bpuklich/d710-gps/images/IMG_20131108_212835.jpg

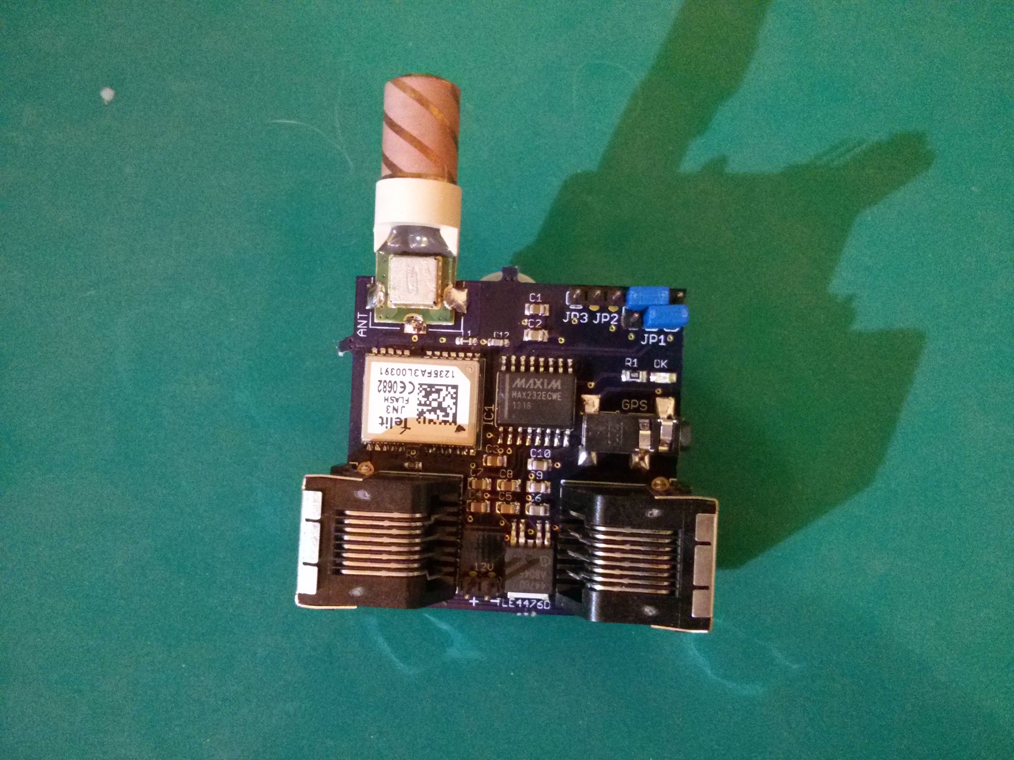
images/IMG_20131108_212835.jpg
