bpuklich/d710-gps/images/top.png

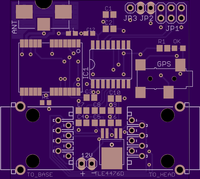
images/top.png
