bpuklich/d710-gps/images/bottom.png

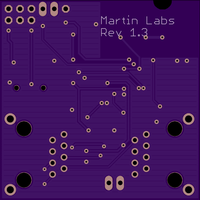
images/bottom.png
