bpuklich/d710-gps/Digikey D710 GPS Parts Pricing.xlsx

Part # | Part | How many / board | $ Per 1 | $ Per 10 | $ Per 100 | $ Per 1000
 |  |  | 1 | 10 | 100 | 1000
943-1016-1-ND | JN3 GPS Module | 1 | 19.17 | 16.43 | 14.375 | 14.375
TLE4476DCT-ND | IC REG TLE4476D | 1 | 3.32 | 2.985 | 2.4325 | 1.65855
1276-2910-1-ND | Cap Ceramic 22uF 10V | 2 | 0.4 | 0.346 | 0.173 | 0.11371
1276-1074-1-ND | Cap Ceramic .47uF 25V | 1 | 0.12 | 0.084 | 0.0385 | 0.021
1276-1007-1-ND | Cap Ceramic .1uF 50V | 1 | 0.1 | 0.031 | 0.0141 | 0.00768
1276-2893-1-ND | Cap Ceramic 10uF 16V | 1 | 0.2 | 0.137 | 0.0696 | 0.04228
1276-2953-1-ND | Cap Ceramic 2.2uF 25V | 1 | 0.16 | 0.11 | 0.0523 | 0.03031
P62ADCT-ND | Res 62 Ohm 1/4W | 1 | 0.23 | 0.0874 | 0.0665 | 0.02432
P100KGCT-ND | Res 100 Ohm 1/10W | 2 | 0.1 | 0.0092 | 0.007 | 0.00256
160-1423-1-ND | LED Green 0805 | 1 | 0.32 | 0.248 | 0.135 | 0.0585
CP-2524SJCT-ND | Conn Audio Jack 2.5mm | 1 | 1.28 | 0.998 | 0.7614 | 0.4912
A31437-ND | Conn RJ45 | 2 | 2.02 | 1.832 | 1.5707 | 1.12193
MAX232ECWE+-ND | MAX232ECWE | 1 | 4.88 | 4.636 | 2.36 | 2.07826
311-1457-1-ND | Cap Ceramic 1uF 16V | 4 | 0.1 | 0.044 | 0.0202 | 0.01101
D710GPSv2 | 2-layer PCB Board made | 1 | 6 | 6 | 6 | 6
SL1204R | Quadrifilar geo helix GPS antenna | 1 | 19 | 19 | 19 | 19
490-2631-1-ND | INDUCTOR 47NH 200MA 0402 | 1 | 0.1 | 0.064 | 0.0448 | 0.03328
490-5868-1-ND | CAP CER 22PF 50V 5% NP0 0402 | 1 | 0.1 | 0.021 | 0.0096 | 0.00525
 |  | Cost Per 1 | 62.02
 |  | Cost Per 10 |  | 55.3818
 |  | Cost Per 100 |  |  | 48.9415
 |  | Cost Per 1000 |  |  |  | 46.34607
 |  | Total investment cost | 62.02 | 553.818 | 4894.15 | 46346.07
 |  | Profit if sold @ $50 | -12.02 | -53.818 | 105.85 | 3653.93
 |  | Profit if sold @ $60 | -2.02 | 46.182 | 1105.85 | 13653.93
 |  | Profit if sold @ $70 | 7.98 | 146.182 | 2105.85 | 23653.93
 |  | Profit if sold @ $80 | 17.98 | 246.182 | 3105.85 | 33653.93
 |  | Profit if sold @ $90 | 27.98 | 346.182 | 4105.85 | 43653.93
 |  | Profit if sold @ $100 | 37.98 | 446.182 | 5105.85 | 53653.93
Geo Helix | http://www.richardsonrfpd.com/Pages/Search-Results.aspx?productCategory=10106&supplierid=1054
 | http://www.richardsonrfpd.com/Pages/Product-Details.aspx?productId=922306
http://www.vetco.net/catalog/product_info.php?products_id=7679
