bpuklich/d710-gps/D710-gps.brd

## EAGLE design D710-gps.brd (2014-01-22)

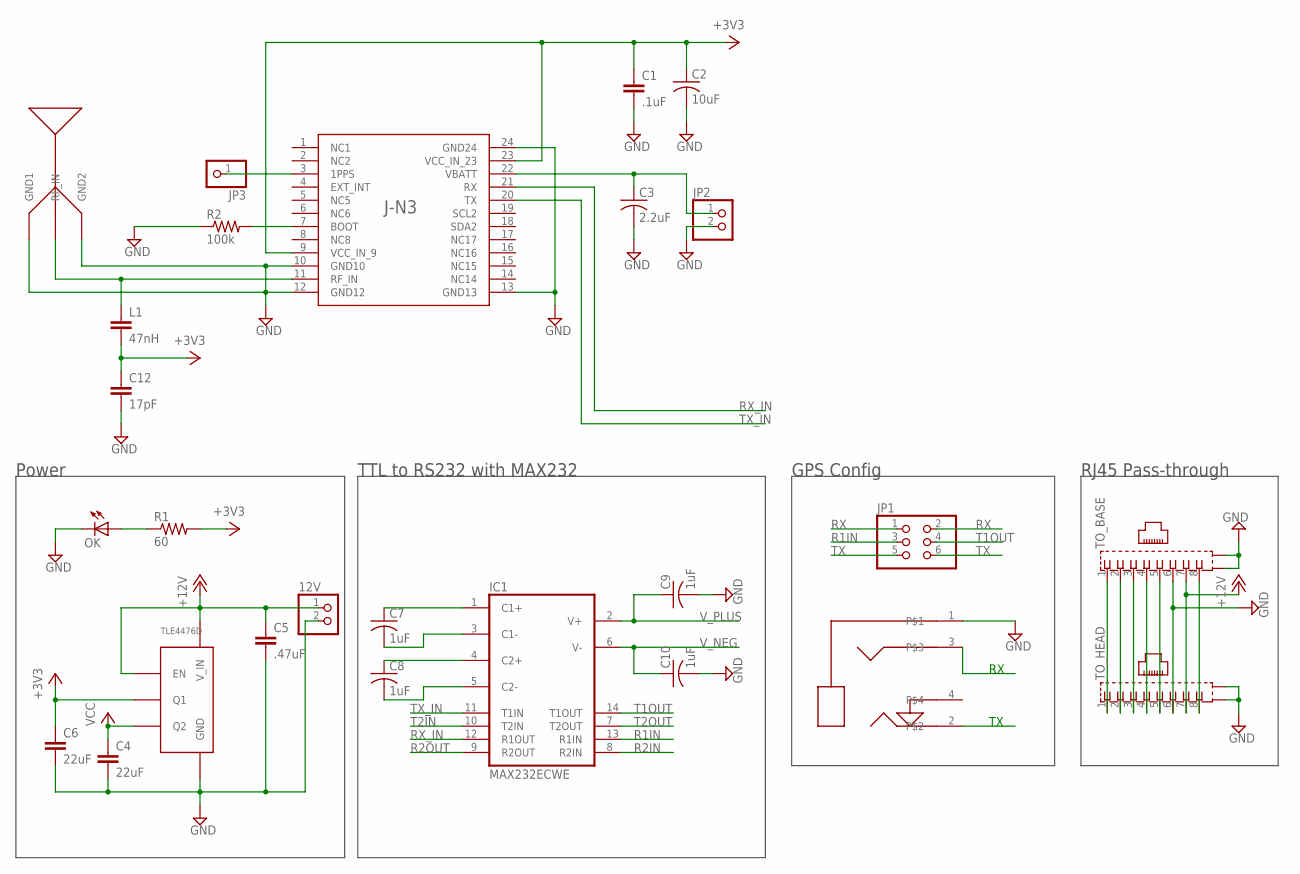
[picture p4: schematic D710-gps.sch]

Parts:
12V: PINHD-1X2; 1X02
ANT: GEO_HELIX_GPSANT
C1: .1uF; C0805
C2: 10uF; C0805; MPN 06034D106MAT2A
C3: 2.2uF; C0805
C4, C6: 22uF; C0805
C5: .47uF; C0805
C7, C8, C9, C10: 1uF; C0805; MPN 02016D105MAT2A
C12: 17pF; C0603
GPS: 2.5MM_JACK; 2.5MM_AUDIO
IC1: MAX232ECWE; SO16L
JP1: PINHD-2X3; 2X03
JP2: PINHD-1X2; 1X02
JP3: PINHD-1X1; 1X01
L1: 47nH; C0603
OK: LEDCHIPLED_0805; CHIPLED_0805
R1: 60; R0805
R2: 100k; R0603
TLE4476D: TLE4476D; TO-252-5
TO_BASE: 555141-1; 555153-1
TO_HEAD: 555141-1; 555153-1
U$1: TELIT_JN3; 24-SMD

Connections:
+3V3: C1.1, C2.1, C6.1, C12.1, L1.2, R1.2, TLE4476D.Q1, U$1.9 (VCC_IN_9), U$1.23 (VCC_IN_23)
+5V: C4.1, IC1.16 (VCC), TLE4476D.Q2
+12V: 12V.1, C5.1, TLE4476D.EN, TLE4476D.V_IN, TO_BASE.7, TO_HEAD.7
GND: 12V.2, ANT.GND1, ANT.GND2, C1.2, C2.2, C3.2, C4.2, C5.2, C6.2, C9.2, C10.2, C12.2, GPS.1, IC1.15 (GND), JP2.2, OK.C, R2.1, TLE4476D.GND, TO_BASE.6, TO_BASE.G1 (S1), TO_BASE.G2 (S2), TO_HEAD.6, TO_HEAD.G1 (S1), TO_HEAD.G2 (S2), U$1.10 (GND10), U$1.12 (GND12), U$1.13 (GND13), U$1.24 (GND24)
unnamed: ANT.RF_IN, L1.1, U$1.11 (RF_IN)
unnamed: OK.A, R1.1
unnamed: R2.2, U$1.7 (BOOT)
unnamed: C3.1, JP2.1, U$1.22 (VBATT)
unnamed: JP3.1, U$1.3 (1PPS)
unnamed: C7.1, IC1.1 (C1+)
unnamed: C7.2, IC1.3 (C1-)
unnamed: C8.1, IC1.4 (C2+)
unnamed: C8.2, IC1.5 (C2-)
unnamed: TO_BASE.1, TO_HEAD.1
unnamed: TO_BASE.2, TO_HEAD.2
unnamed: TO_BASE.3, TO_HEAD.3
unnamed: TO_BASE.4, TO_HEAD.4
unnamed: TO_BASE.5, TO_HEAD.5
unnamed: TO_BASE.8, TO_HEAD.8
R1IN: IC1.13 (R1IN), JP1.3
R2IN: IC1.8 (R2IN)
R2OUT: IC1.9 (R2OUT)
RX: GPS.3, JP1.1, JP1.2
RX_IN: IC1.12 (R1OUT), U$1.21 (RX)
T1OUT: IC1.14 (T1OUT), JP1.4
T2IN: IC1.10 (T2IN)
T2OUT: IC1.7 (T2OUT)
TX: GPS.2, JP1.5, JP1.6
TX_IN: IC1.11 (T1IN), U$1.20 (TX)
V_NEG: C10.1, IC1.6 (V-)
V_PLUS: C9.1, IC1.2 (V+)

Notes on the sheet:
GPS Config
RJ45 Pass-through
Power
TTL to RS232 with MAX232

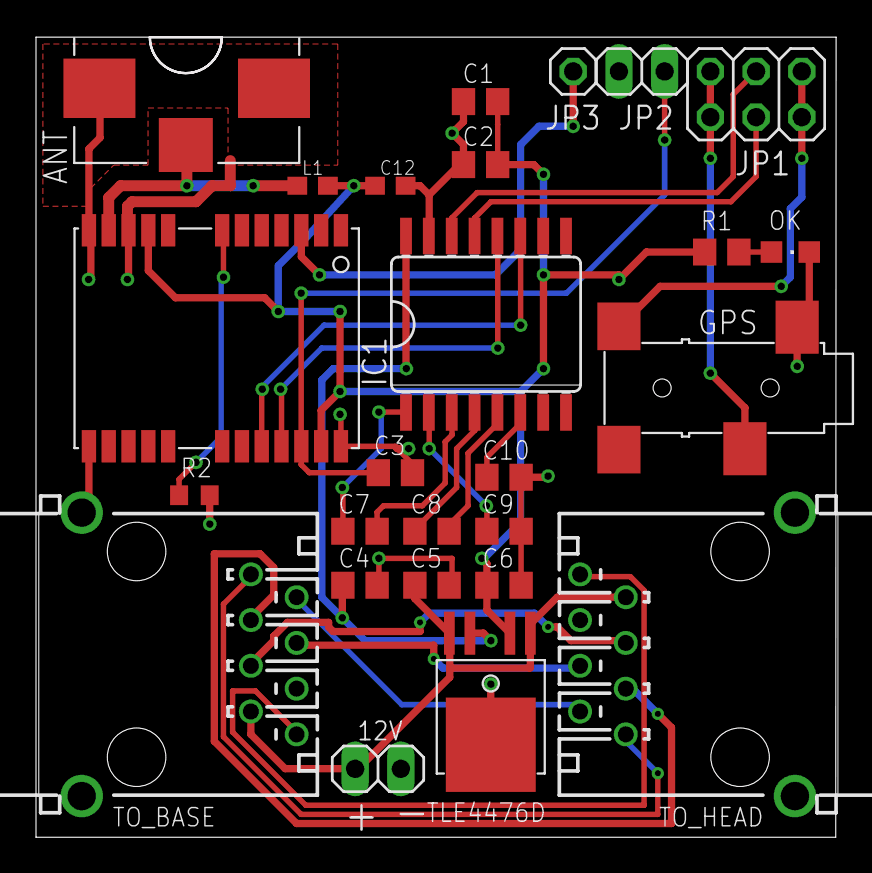
[picture p5: board D710-gps.brd from above]

Board: 2 copper layers, 44.5 x 44.5 mm, 26 parts (0 on the bottom side), 27 nets.
