bpuklich/d710-gps/(commit log)

2014-01-22 Adding initial files
    [untitled.brd, untitled.sch]
2014-01-22 Renamed files
    [D710-gps.brd, D710-gps.sch]
2014-01-22 Added parts file. Parts not contained within this file should be in the default eagle cad library directory.
2014-01-22 Added images of the actual completed board and renderings of the PCB
2014-02-05 Added Parts list
    [Digikey D710 GPS Parts Pricing.xlsx]
